MostafaELFEEL/Semi-Autonomous-Train-Ticket-Examiner-Robot-Komsary/Videos, Pictures, Poster/Inside Look.png

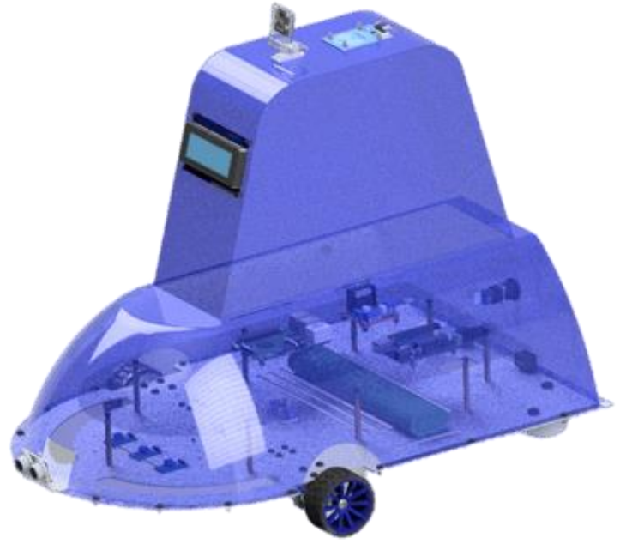
Videos, Pictures, Poster/Inside Look.png
