MostafaELFEEL/Semi-Autonomous-Train-Ticket-Examiner-Robot-Komsary/Videos, Pictures, Poster/Face Detection.png

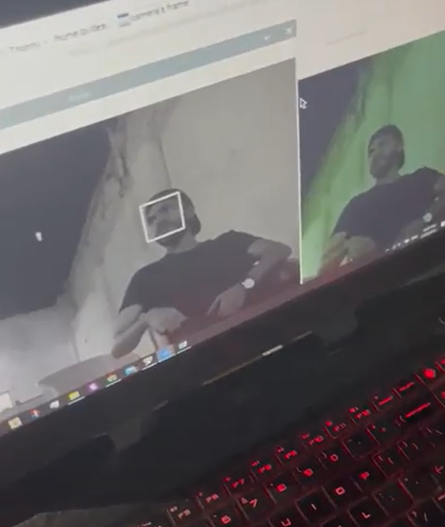
Videos, Pictures, Poster/Face Detection.png
