MostafaELFEEL/Semi-Autonomous-Train-Ticket-Examiner-Robot-Komsary/Videos, Pictures, Poster/poster.pdf

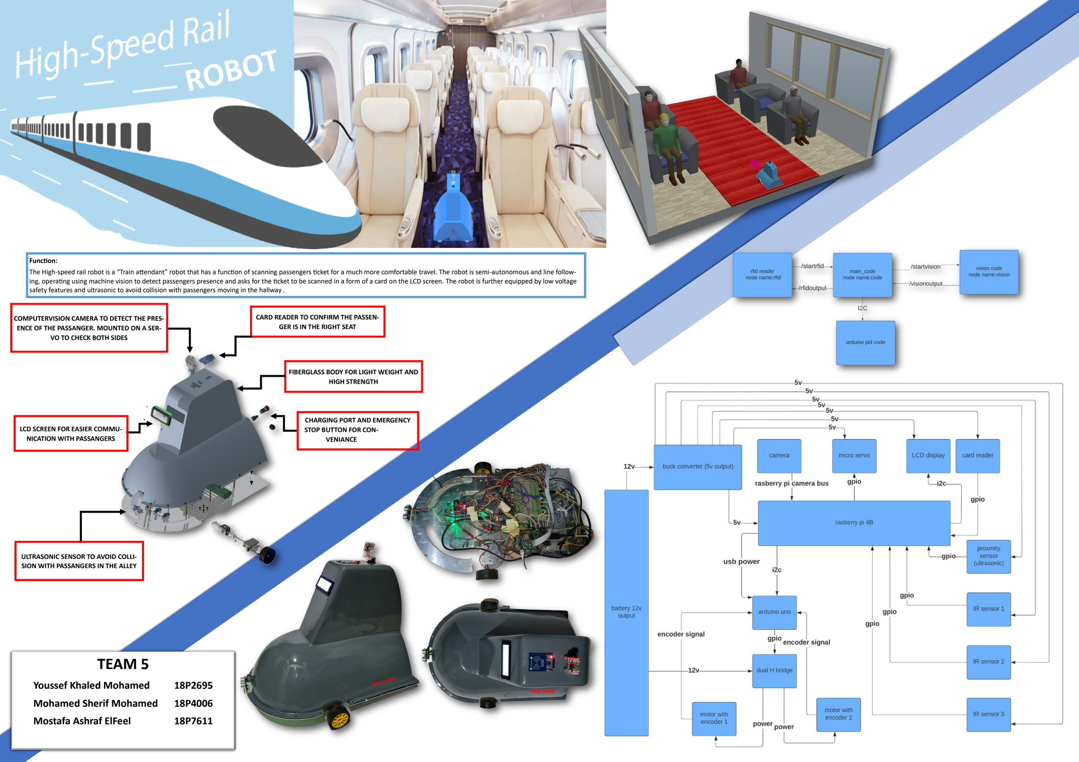
[picture p3: page 1]

LCD SCREEN FOR EASIER COMMU-NICATION WITH PASSANGERS

ULTRASONIC SENSOR TO AVOID COLLI-SION WITH PASSANGERS IN THE ALLEY

COMPUTERVISION CAMERA TO DETECT THE PRES-ENCE OF THE PASSANGER. MOUNTED ON A SER-VO TO CHECK BOTH SIDES

CARD READER TO CONFIRM THE PASSEN-GER IS IN THE RIGHT SEAT

FIBERGLASS BODY FOR LIGHT WEIGHT AND HIGH STRENGTH

CHARGING PORT AND EMERGENCY STOP BUTTON FOR CON-VENIANCE

Real model

# TEAM 5

Youssef Khaled Mohamed | 18P2695
Mohamed Sherif Mohamed | 18P4006
Mostafa Ashraf ElFeel | 18P7611

Function:
The High-speed rail robot is a “Train attendant” robot that has a function of scanning passengers ticket for a much more comfortable travel. The robot is semi-autonomous and line following, operating using machine vision to detect passengers presence and asks for the ticket to be scanned in a form of a card on the LCD screen. The robot is further equipped by low voltage safety features and ultrasonic to avoid collision with passengers moving in the hallway .
