MostafaELFEEL/Semi-Autonomous-Train-Ticket-Examiner-Robot-Komsary/Videos, Pictures, Poster/General Specifications.png

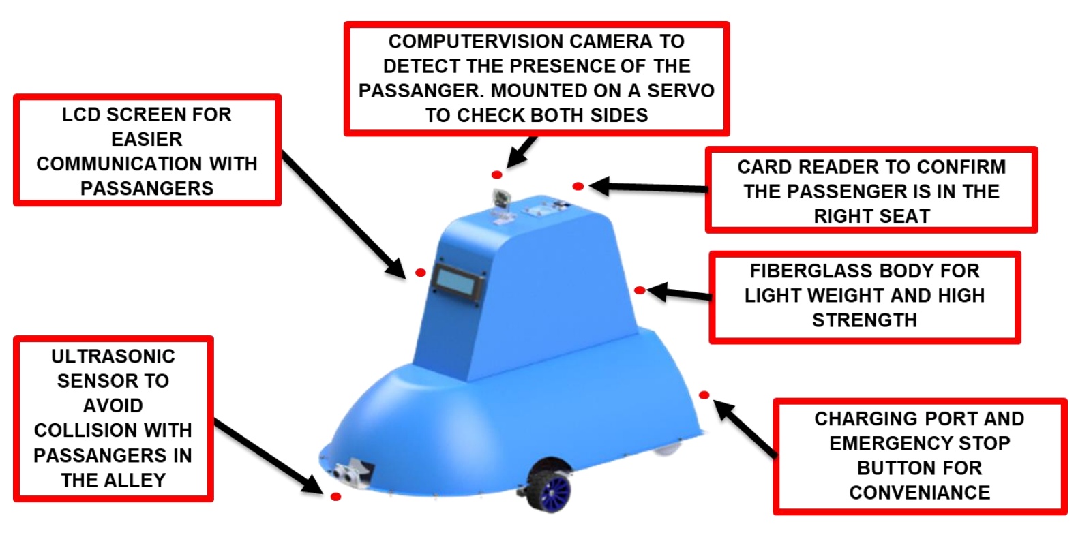
Videos, Pictures, Poster/General Specifications.png
